nseuf/NixieTubeClock/README.md

# NixieTubeClock
NixieTubeClock is a GPS-based desk clock that is precise up to 10ms, and uses nixie tubes to display the time.
