nseuf/NixieTubeClock/electronics/USBC_passthrough/production/bom.csv

Designator | Footprint | Quantity | Value | LCSC Part #
J1 | TYPE-C-SMD_USB4120-03-C | 1 | USB_C_Receptacle_USB2.0_16P
J2 | USB-C-SMD_TYPEC-302-BRP16SC16 | 1 | USB_C_Receptacle_USB2.0_16P
R1, R2 | 0603 | 2 | 5k1
