nseuf/NixieTubeClock/cad/2025.06.11.Clock.PCB Holder Part2.STL

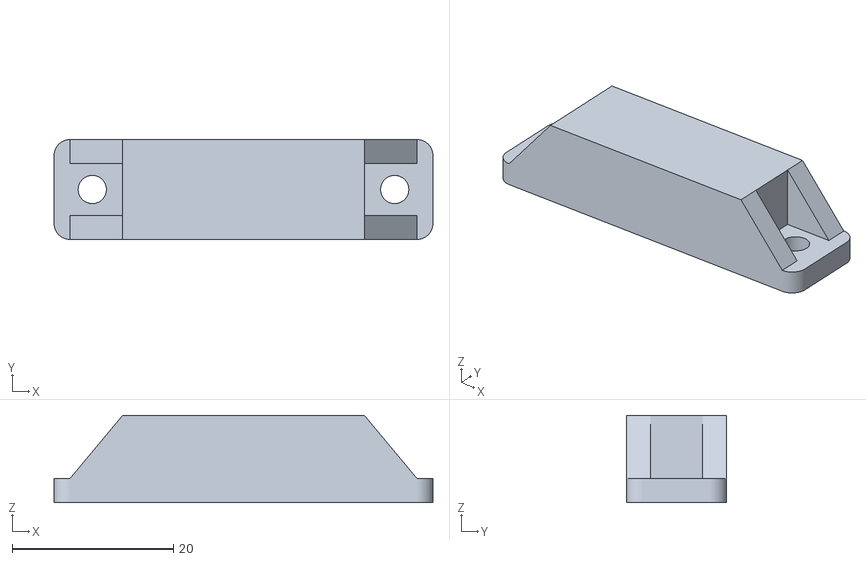
[picture p1: CAD file, 2025-11-16]
cad/2025.06.11.Clock.PCB Holder Part2.STL
47.0 x 12.4 x 10.8
