nseuf/NixieTubeClock/electronics/gps_clock/KiCADv6/KiCADv6/7447709330/WE-PD_1210.step

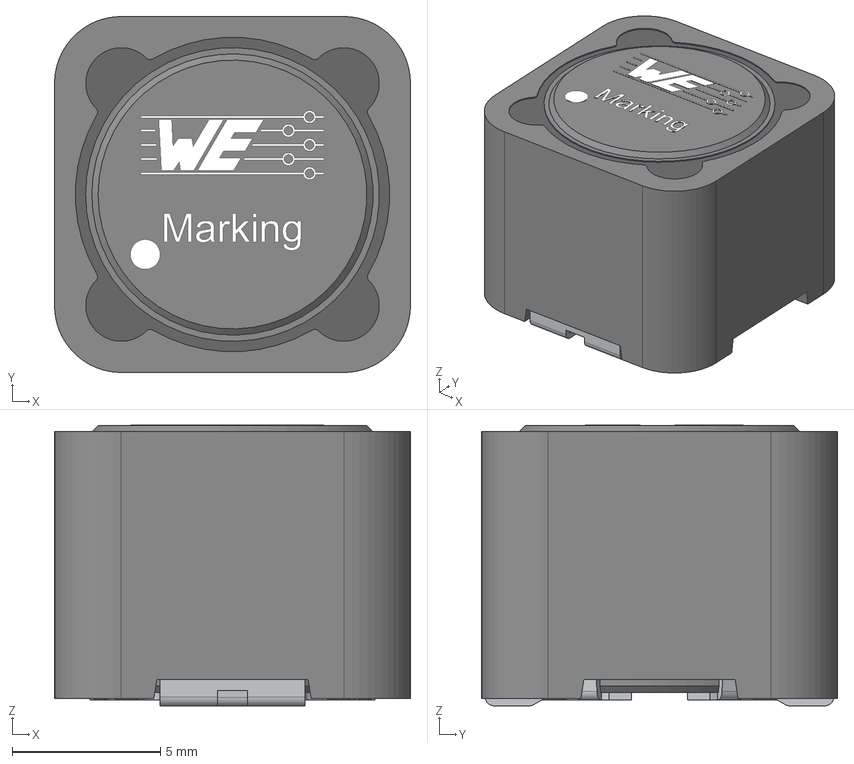
[picture p2: CAD file, 2025-08-10]
electronics/gps_clock/KiCADv6/KiCADv6/7447709330/WE-PD_1210.step
12.0 x 12.0 x 9.46 mm
Core
ShieldRing
Glue
Leadframe
