nseuf/NixieTubeClock/electronics/touch_sensor/TouchSensor.step

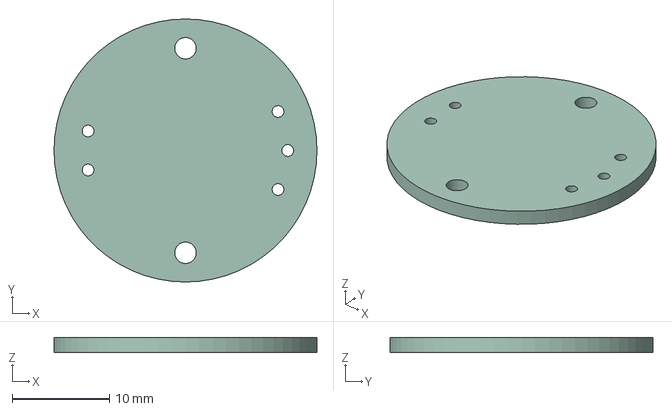
[picture p4: CAD file, 2025-08-10]
electronics/touch_sensor/TouchSensor.step
27.0 x 27.0 x 1.51 mm
