nseuf/NixieTubeClock/cad/2025.06.16.Clock.PCB Holder Part1.STL

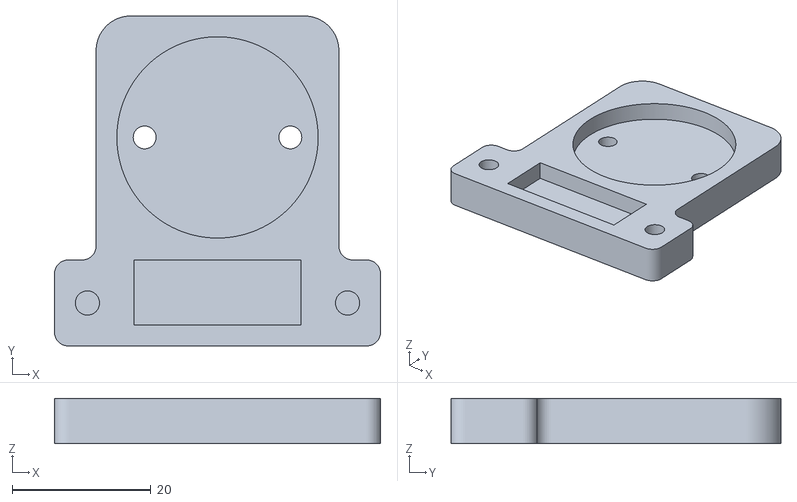
[picture p5: CAD file, 2025-11-16]
cad/2025.06.16.Clock.PCB Holder Part1.STL
47.0 x 47.6 x 6.50
