nseuf/NixieTubeClock/electronics/touch_sensor/Manufacturing/TouchSensor-B_Cu.dxf

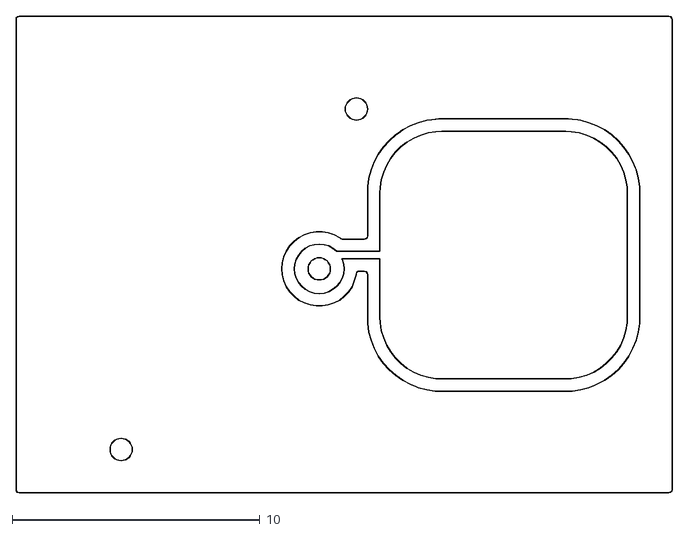
[picture p6: CAD file, 2025-08-10]
electronics/touch_sensor/Manufacturing/TouchSensor-B_Cu.dxf
26.5 x 19.2
