nseuf/NixieTubeClock/electronics/touch_sensor/Manufacturing/TouchSensor-User_Eco1.dxf

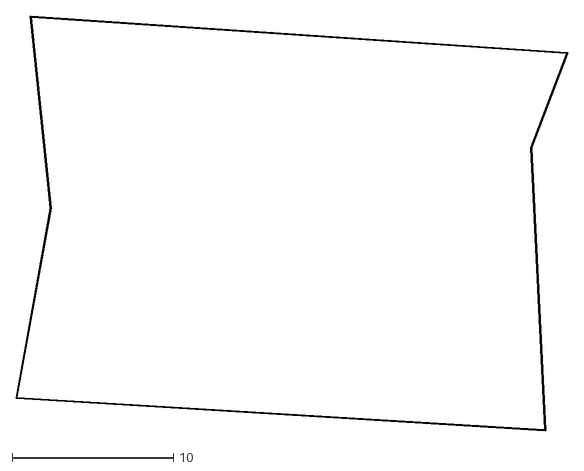
[picture p7: CAD file, 2025-08-10]
electronics/touch_sensor/Manufacturing/TouchSensor-User_Eco1.dxf
34.2 x 25.7
