nseuf/NixieTubeClock/electronics/touch_sensor/Manufacturing/TouchSensor-Edge_Cuts.dxf

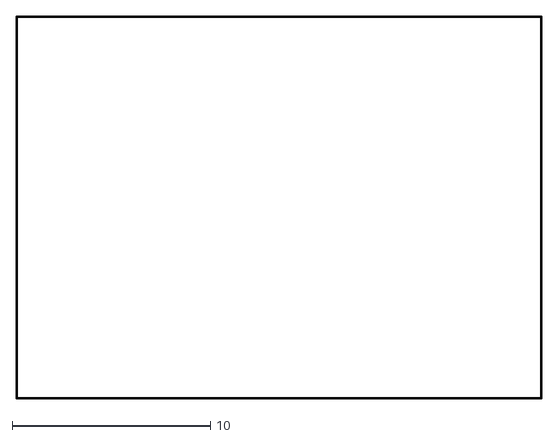
[picture p8: CAD file, 2025-08-10]
electronics/touch_sensor/Manufacturing/TouchSensor-Edge_Cuts.dxf
26.6 x 19.3
