nseuf/NixieTubeClock/(list of files, cad)

Other CAD files:
cad/BackFace.x_t
cad/Clock.Housing.x_t
cad/FrontFace.x_t
electronics/touch_sensor/Manufacturing/TouchSensor-B_Mask.dxf
electronics/touch_sensor/Manufacturing/TouchSensor-F_Mask.dxf
