nseuf/NixieTubeClock/cad/2025.08.11.Assem Clock.pdf

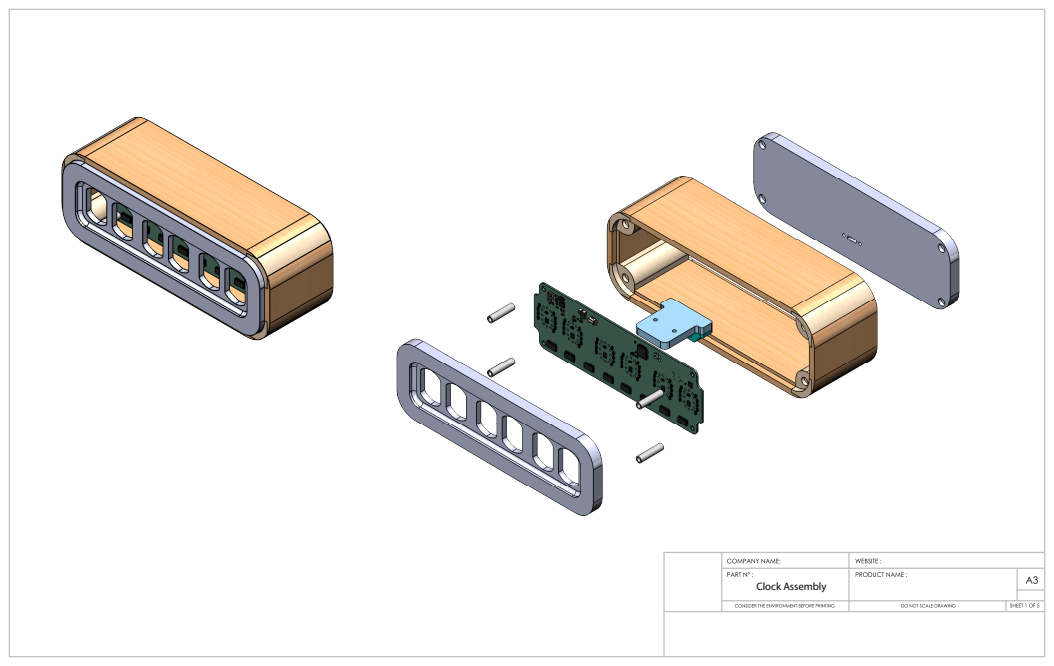
[picture p11: page 1]
Clock Assembly

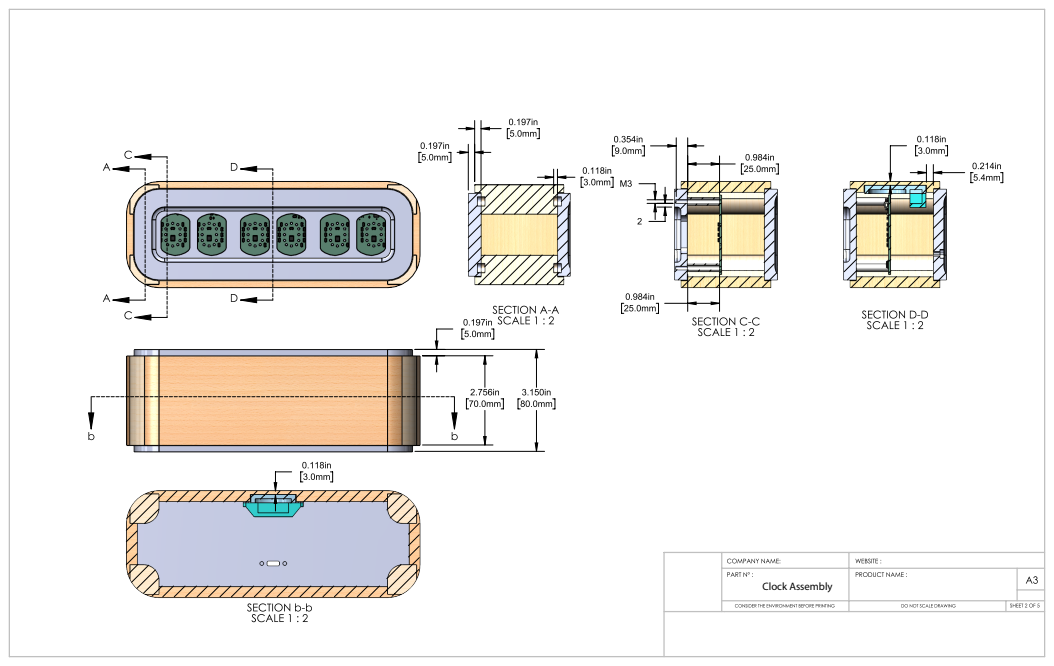
[picture p12: page 2]
Clock Assembly

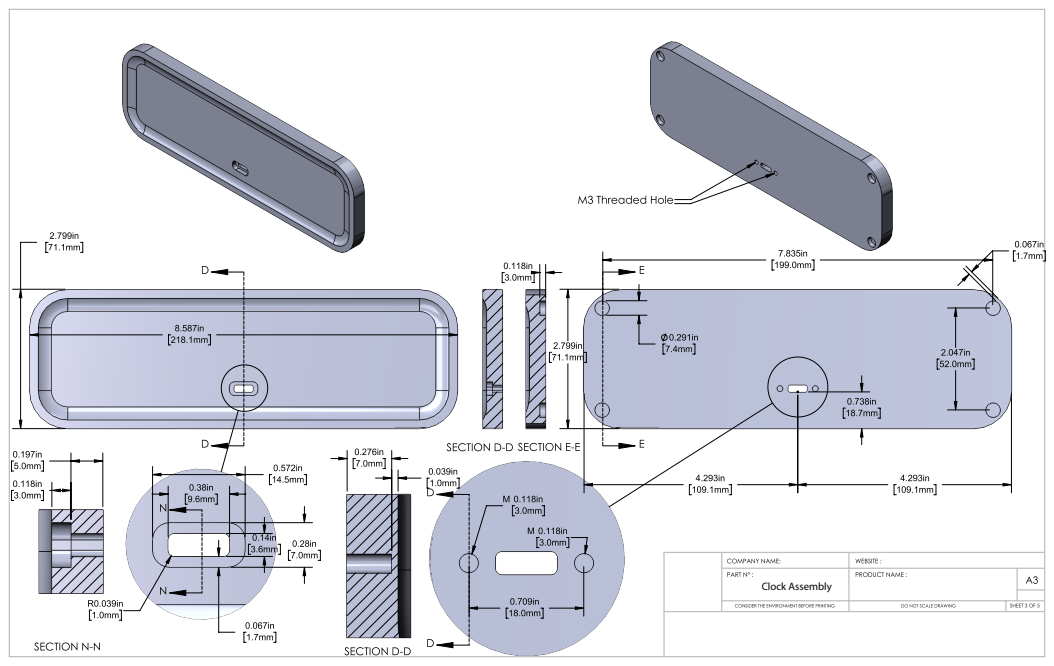
[picture p13: page 3]
Clock Assembly

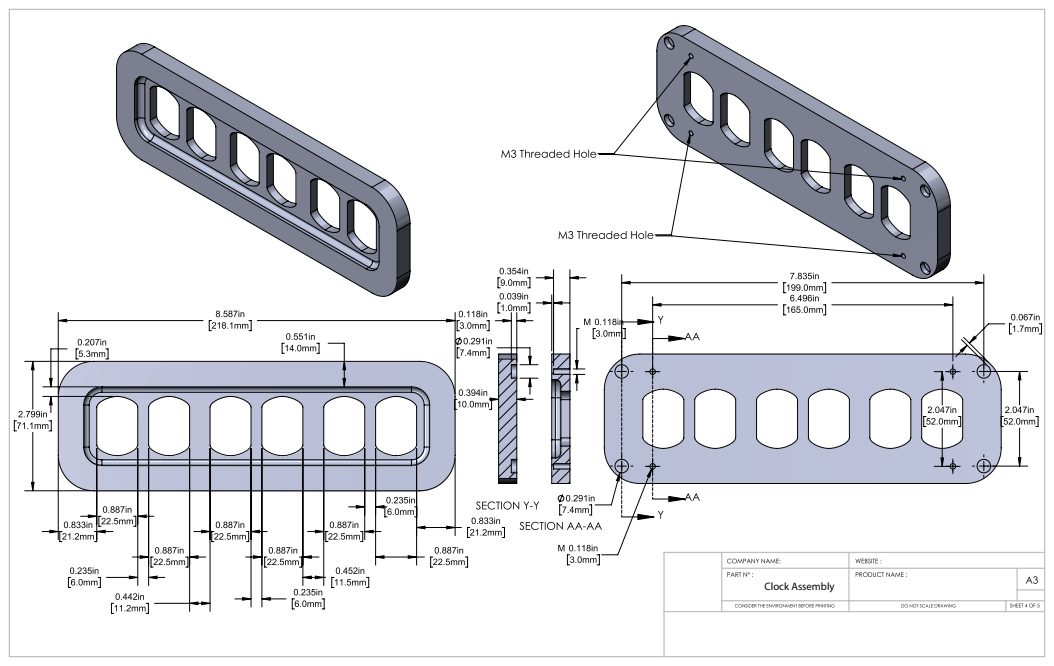
[picture p14: page 4]
Clock Assembly

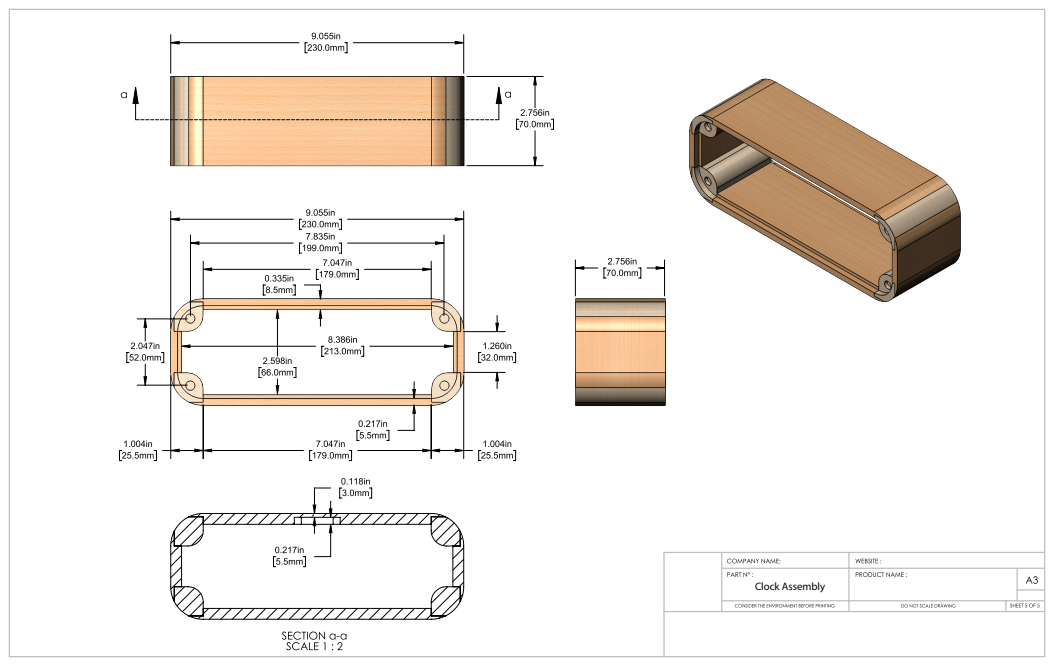
[picture p15: page 5]
Clock Assembly
