nseuf/NixieTubeClock/(list of files, drawings)

Other design files:
electronics/gps_clock/gps_clock.dsn
