nseuf/NixieTubeClock/electronics/USBC_passthrough/USBCPassthrough.kicad_pcb

## KiCad design electronics/USBC_passthrough/USBCPassthrough.kicad_pcb (2025-11-16)

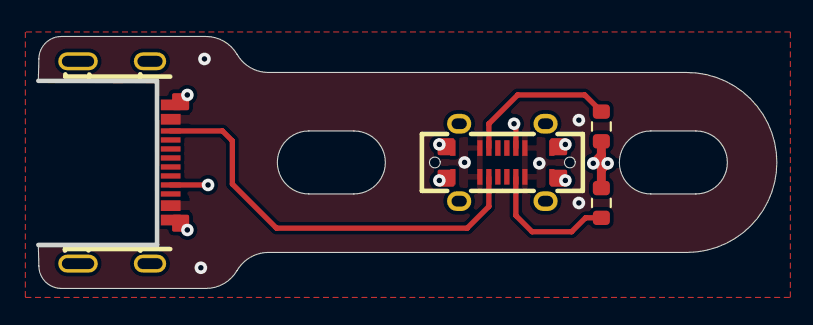
[picture p16: board USBCPassthrough.kicad_pcb from above]

Board: 4 copper layers, 41.0 x 14.0 mm, 4 parts (0 on the bottom side), 6 nets.

Parts:
J1: USB_C_Receptacle_USB2.0_16P; TYPE-C-SMD_USB4120-03-C
J2: USB_C_Receptacle_USB2.0_16P; USB-C-SMD_TYPEC-302-BRP16SC16
R1, R2: 5k1; R_0603_1608Metric

Connections:
+5V: J1.A4 (VBUS), J1.A9 (VBUS), J1.B4 (VBUS), J1.B9 (VBUS), J2.A4 (VBUS), J2.B4 (VBUS)
GND: J1.A1 (GND), J1.A12 (GND), J1.B1 (GND), J1.B12 (GND), J1.S1 (SHIELD), J2.A1 (GND), J2.B1 (GND), J2.S1 (SHIELD), R1.2, R2.2
unnamed: J1.A5 (CC1), R2.1
unnamed: J1.B5 (CC2), R1.1
unnamed: J1.A8 (SBU1), J2.A8 (SBU1)
unnamed: J1.B8 (SBU2), J2.B8 (SBU2)
