nseuf/NixieTubeClock/electronics/touch_sensor/TouchSensor.kicad_pcb

## KiCad design electronics/touch_sensor/TouchSensor.kicad_pcb (2025-08-10)

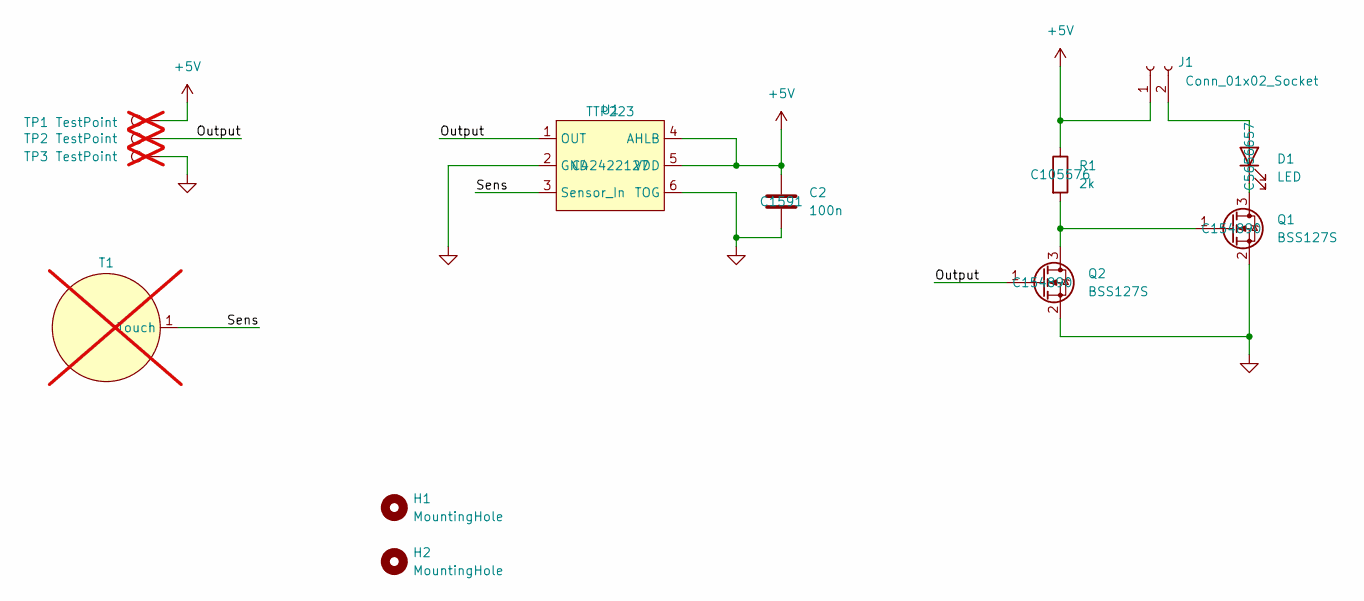
[picture p17: schematic TouchSensor.kicad_sch]

Parts:
C2: 100n; C_0603_1608Metric; LCSC_Part# C1591
D1: LED; D_0603_1608Metric; LCSC_Part# C5656657
H1, H2: MountingHole; MountingHole_2.2mm_M2_ISO7380
J1: Conn_01x02_Socket; JST_SUR_BM02B-SURS-TF_1x02-1MP_P0.80mm_Vertical
Q1, Q2: BSS127S; SOT-23; LCSC_Part# C154890
R1: 2k; R_0603_1608Metric; LCSC_Part# C105576
T1: TouchPad; not fitted
TP1, TP2, TP3: TestPoint; TestPoint_THTPad_D2.5mm_Drill1.2mm; not fitted
U1: TTP223; SOT-23-6; LCSC_Part# C42422127

Connections:
+5V: C2.1, J1.1, R1.1, TP1.1, U1.4 (AHLB), U1.5 (VDD)
/Output: Q2.1 (G), TP2.1, U1.1 (OUT)
/Sens: T1.1 (Touch), U1.3 (Sensor_In)
GND: C2.2, Q1.2 (S), Q2.2 (S), TP3.1, U1.2 (GND), U1.6 (TOG)
unnamed: D1.2 (A), J1.2
unnamed: D1.1 (K), Q1.3 (D)
unnamed: Q1.1 (G), Q2.3 (D), R1.2

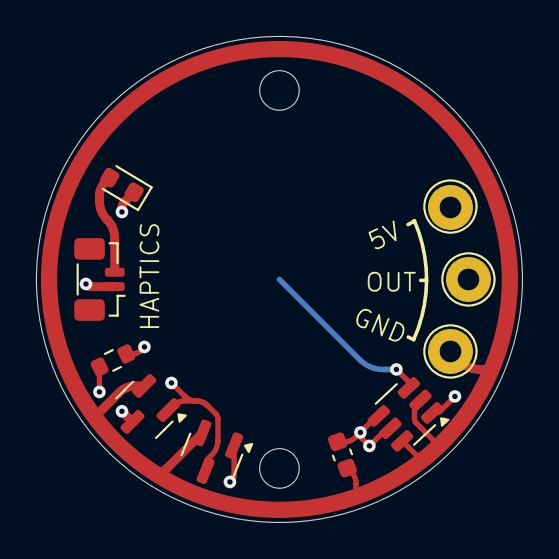
[picture p18: board TouchSensor.kicad_pcb from above]

Board: 4 copper layers, 27.0 x 27.0 mm, 13 parts (1 on the bottom side), 7 nets.
