nseuf/NixieTubeClock/electronics/gps_clock/gps_clock.kicad_pcb

## KiCad design electronics/gps_clock/gps_clock.kicad_pcb (2025-08-10)

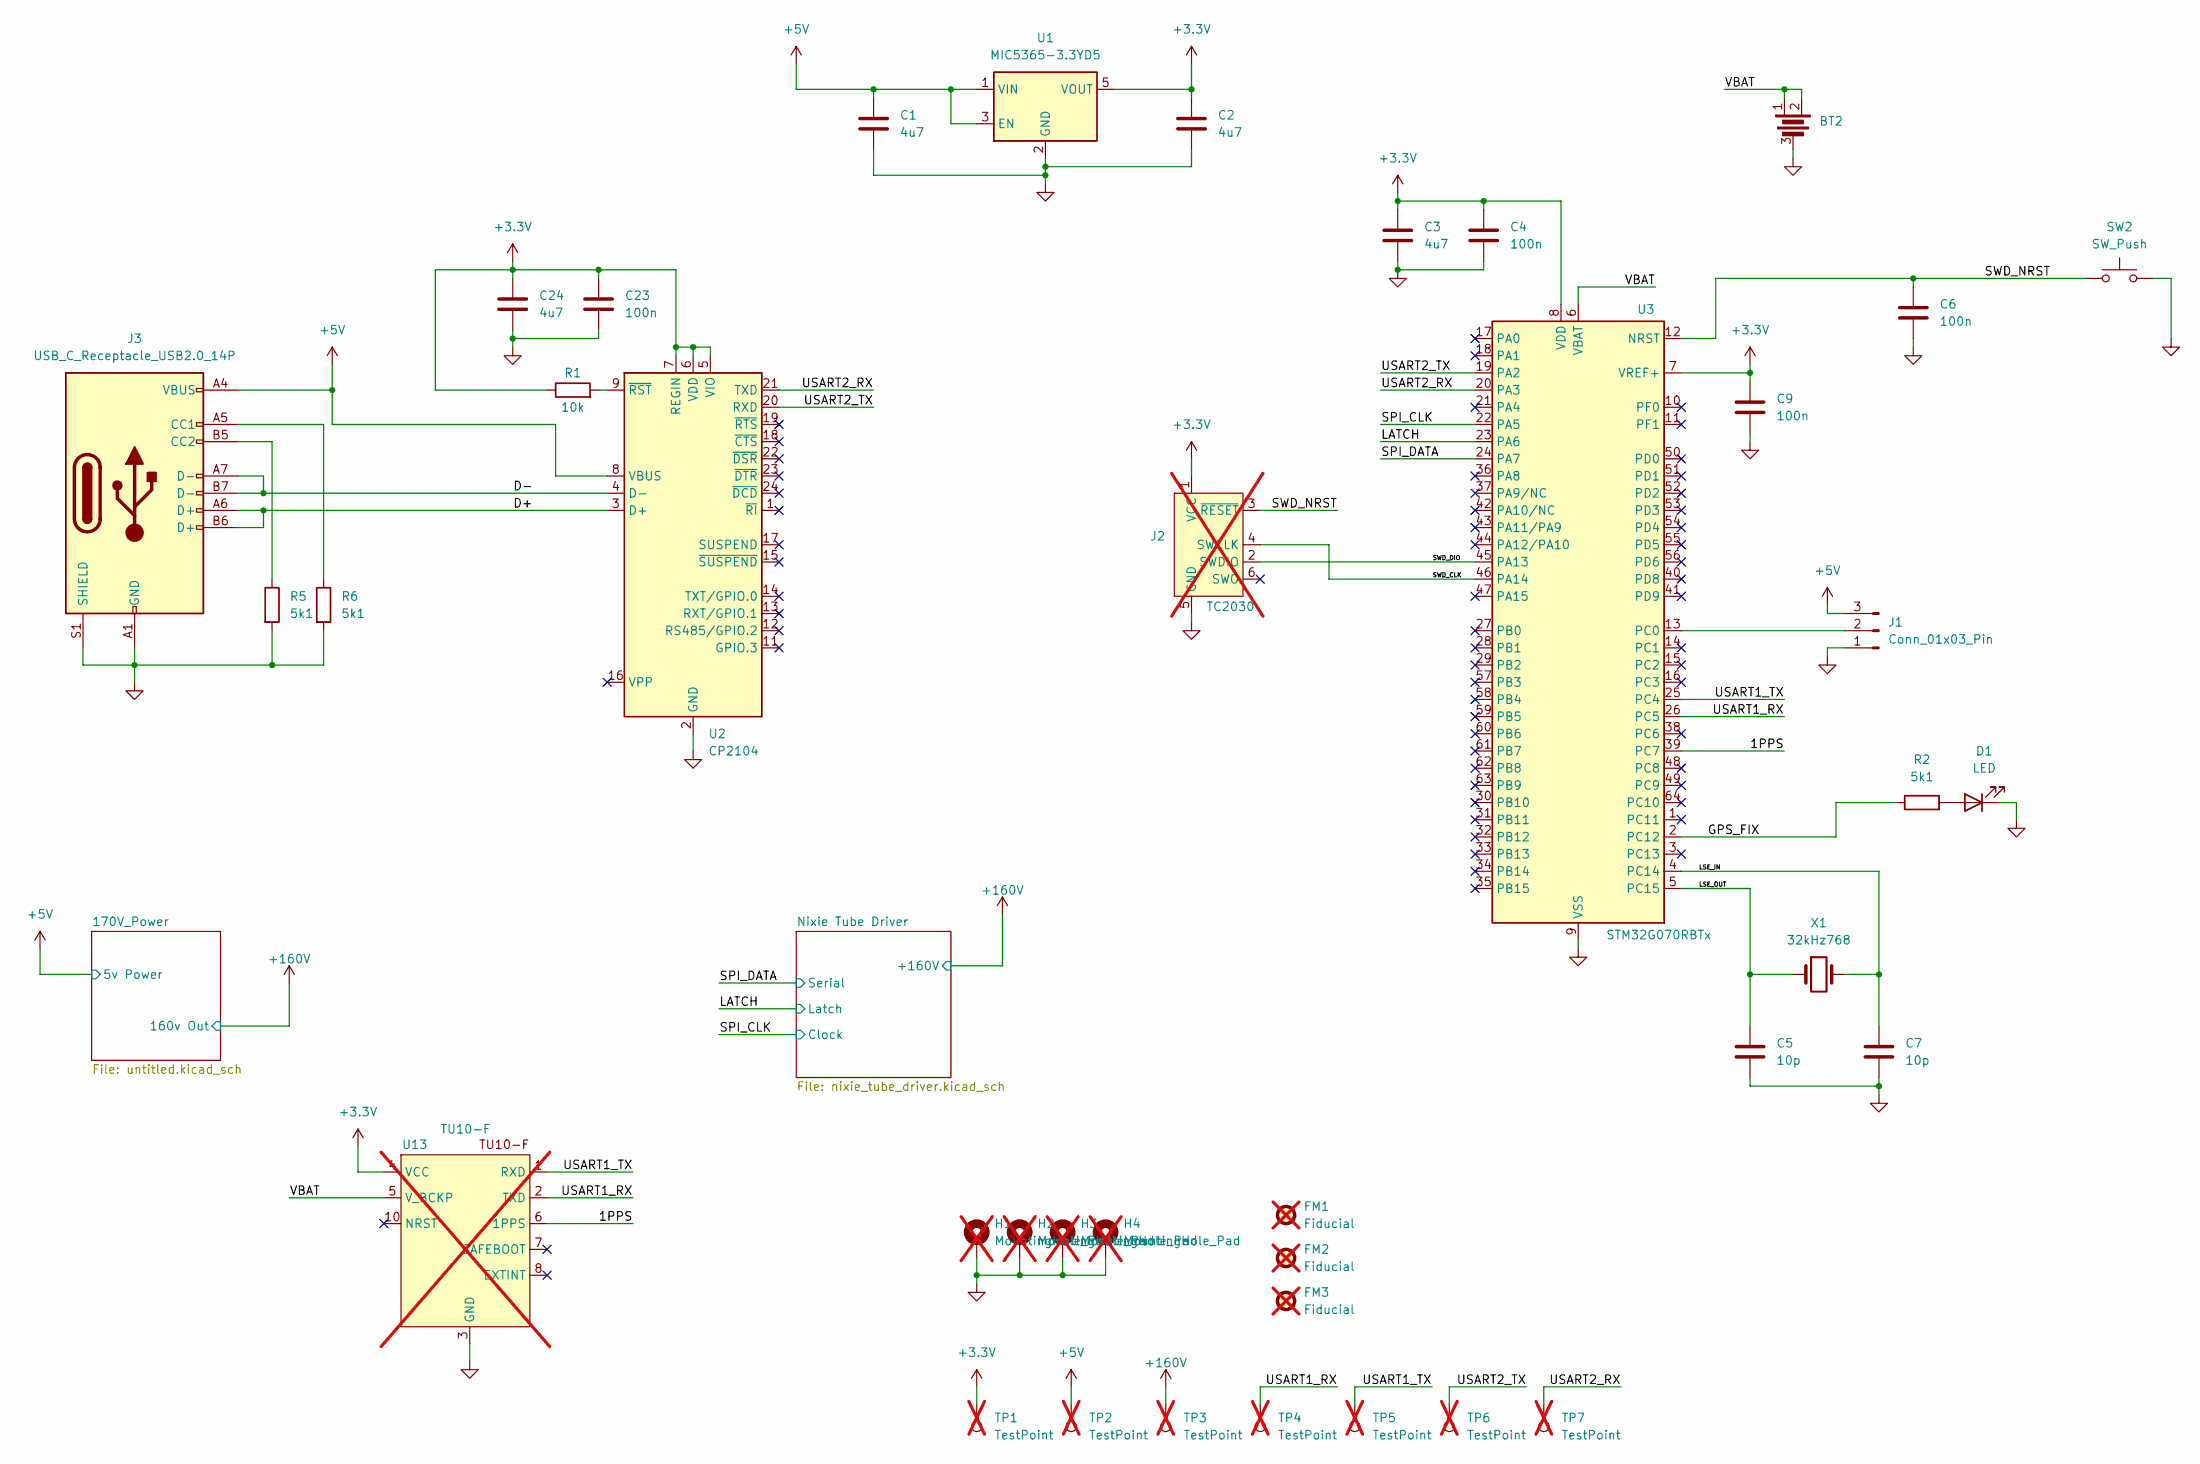
[picture p19: schematic gps_clock.kicad_sch, GPS Clock]

Parts:
BT2: BAT-SMD_MY-1220-03; LCSC_Part# C20606802
C1, C2, C3, C24: 4u7; C_0603_1608Metric; MFR_Part# CL10A475KP8NNNC; LCSC_Part# C1705
C4, C6, C9, C23: 100n; C_0402_1005Metric; MFR_Part# CL05B104KO5NNNC; LCSC_Part# C1525
C5, C7: 10p; C_0402_1005Metric; MFR_Part# 0402CG100J500NT; LCSC_Part# C1545
D1: LED; D_0603_1608Metric; LCSC_Part# C5656657
FM1, FM2, FM3: Fiducial; Fiducial_1mm_Mask2mm; not fitted
H1, H2, H3, H4: MountingHole_Pad; MountingHole_3mm_Pad_Via; not fitted
J1: Conn_01x03_Pin; Molex_PicoBlade_53261-0371_1x03-1MP_P1.25mm_Horizontal; LCSC_Part# C293630
J2: TC2030; Tag-Connect_TC2030-IDC-FP_2x03_P1.27mm_Vertical; MFR_Part# N/A; LCSC_Part# N/A; not fitted
J3: USB_C_Receptacle_USB2.0_14P; USB-C-SMD_U263-241N-4BQC02; LCSC_Part# C2689742
R1: 10k; R_0603_1608Metric; MFR_Part# 0402WGF5101TCE; LCSC_Part# C15401
R2, R5, R6: 5k1; R_0402_1005Metric; MFR_Part# 0402WGF5101TCE; LCSC_Part# C25905
SW2: SW_Push; SW_Push_1P1T_XKB_TS-1187A; MFR_Part# TS-1187A-B-A-B; LCSC_Part# C318884
TP1, TP2, TP3, TP4, TP5, TP6, TP7: TestPoint; TestPoint_Pad_D2.5mm; LCSC_Part# N/A; not fitted
U1: MIC5365-3.3YD5; SOT-23-5; MFR_Part# MIC5365-3.3YD5-TR; LCSC_Part# C626098
U2: CP2104; QFN-24-1EP_4x4mm_P0.5mm_EP2.7x2.7mm; LCSC_Part# C47742
U3: STM32G070RBTx; LQFP-64_10x10mm_P0.5mm; MFR_Part# STM32G070RBT6; LCSC_Part# C529340
U13: TU10-F; LCSC_Part# N/A; not fitted
X1: 32kHz768; Crystal_SMD_2012-2Pin_2.0x1.2mm; MFR_Part# NX2012SA-32.768KHZ-EXS00A-MU00644; LCSC_Part# C2828558

Connections:
+3.3V: C2.1, C3.1, C4.1, C9.1, C23.1, C24.1, J2.1 (VCC), R1.1, TP1.1, U1.5 (VOUT), U2.5 (VIO), U2.6 (VDD), U2.7 (REGIN), U3.7 (VREF+), U3.8 (VDD), U13.4 (VCC)
+5V: C1.1, J1.3, J3.A4 (VBUS), J3.A9 (VBUS), J3.B4 (VBUS), J3.B9 (VBUS), TP2.1, U1.1 (VIN), U1.3 (EN), U2.8 (VBUS); also elsewhere on the board
+160V: TP3.1; also elsewhere on the board
/1PPS: U3.39 (PC7), U13.6 (1PPS)
/D+: J3.A6 (D+), J3.B6 (D+), U2.3 (D+)
/D-: J3.A7 (D-), J3.B7 (D-), U2.4 (D-)
/GPS_FIX: R2.1, U3.2 (PC12)
/LATCH: U3.23 (PA6); also elsewhere on the board
/LSE_IN: C7.1, U3.4 (PC14), X1.2
/LSE_OUT: C5.1, U3.5 (PC15), X1.1
/SPI_CLK: U3.22 (PA5); also elsewhere on the board
/SPI_DATA: U3.24 (PA7); also elsewhere on the board
/SWD_CLK: J2.4 (SWCLK), U3.46 (PA14)
/SWD_DIO: J2.2 (SWDIO), U3.45 (PA13)
/SWD_NRST: C6.1, J2.3 (~RESET), SW2.1, U3.12 (NRST)
/USART1_RX: TP4.1, U3.26 (PC5), U13.2 (TXD)
/USART1_TX: TP5.1, U3.25 (PC4), U13.1 (RXD)
/USART2_RX: TP7.1, U2.21 (TXD), U3.20 (PA3)
/USART2_TX: TP6.1, U2.20 (RXD), U3.19 (PA2)
/VBAT: BT2.1, BT2.2, U3.6 (VBAT), U13.5 (V_BCKP)
GND: BT2.3, C1.2, C2.2, C3.2, C4.2, C5.2, C6.2, C7.2, C9.2, C23.2, C24.2, D1.1 (K), H1.1, H2.1, H3.1, H4.1, J1.1, J2.5 (GND), J3.A1 (GND), J3.A12 (GND), J3.B1 (GND), J3.B12 (GND), J3.S1 (SHIELD), R5.2, R6.2, SW2.2, U1.2 (GND), U2.2 (GND), U2.25 (GND), U3.9 (VSS), U13.3 (GND), U13.12 (GND); also elsewhere on the board
unnamed: D1.2 (A), R2.2
unnamed: J1.2, U3.13 (PC0)
unnamed: J3.A5 (CC1), R6.1
unnamed: J3.B5 (CC2), R5.1
unnamed: R1.2, U2.9 (~RST)

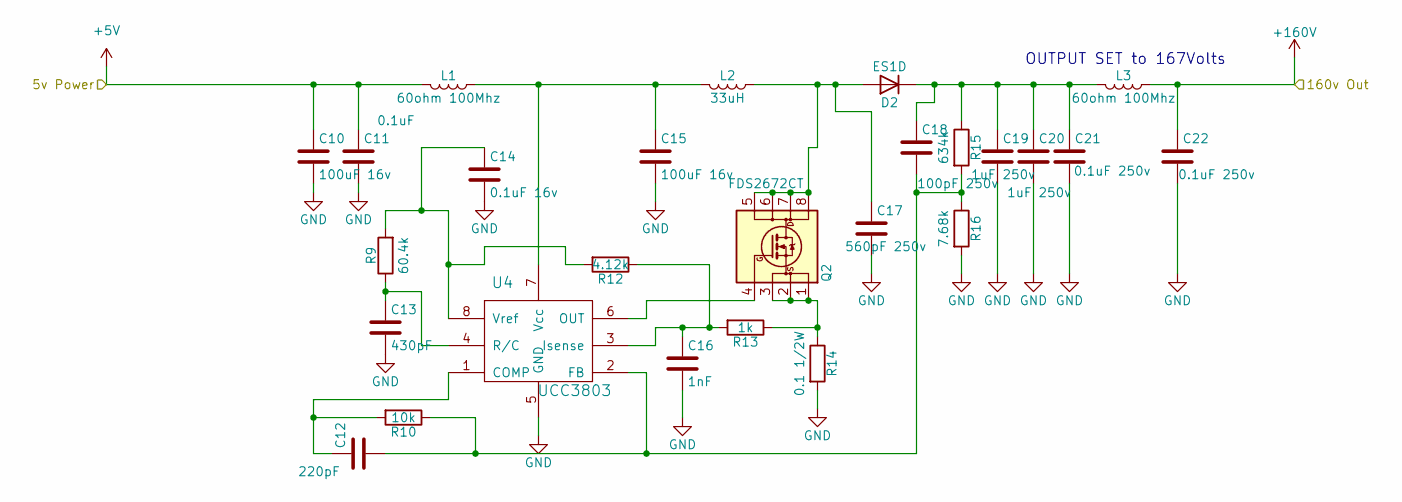
[picture p20: schematic untitled.kicad_sch, 170V Power Supply]

Parts:
C10, C15: 100uF 16v; C_1210_3225Metric; MPN EMK325ABJ107MM-P; LCSC_Part# C90143
C11: 0.1uF; C_0805_2012Metric; MPN C0805C104K3RACTU; LCSC_Part# C1852967
C12: 220pF; C_0805_2012Metric; MPN C0805C221M5RACTU; LCSC_Part# C1727
C13: 430pF; C_0805_2012Metric; MPN CL21C431JBANNNC; LCSC_Part# C67898
C14: 0.1uF 16v; C_0805_2012Metric; MPN C0805C104K3RACTU; LCSC_Part# C519980
C16: 1nF; C_0805_2012Metric; MPN C0805C102M5RACTU; LCSC_Part# C46553
C17: 560pF 250v; C_0805_2012Metric; MPN C0603C561JAGAC7867; LCSC_Part# C113870
C18: 100pF 250v; C_0805_2012Metric; MPN C0805C101JAGAC7800; LCSC_Part# C2929108
C19, C20: 1uF 250v; C_1812_4532Metric; MPN C4532X7T2E105M250KE; LCSC_Part# C106152
C21, C22: 0.1uF 250v; C_0805_2012Metric; MPN CGA4J3X7T2E104M125AE; LCSC_Part# C5451689
D2: ES1D; D_SMA; MPN ES1D; LCSC_Part# C84602
L1, L3: 60ohm 100Mhz; R_0805_2012Metric; MPN BKP2125HS600-T; LCSC_Part# C44362
L2: 33uH; WE-PD_1210; MPN 7447709330; LCSC_Part# C2651182
Q2: FDS2672CT; SOIC-8_3.9x4.9mm_P1.27mm; MPN FDS2672CT-ND; LCSC_Part# C463724
R9: 60.4k; R_0805_2012Metric; MPN RC0805FR-0760K4L; LCSC_Part# C218645
R10: 10k; R_0603_1608Metric; MFR_Part# 0603WAJ0103T5E; LCSC_Part# C15401
R12: 4.12k; R_0805_2012Metric; MPN RC0805FR-074K12L; LCSC_Part# C218607
R13: 1k; R_0805_2012Metric; MPN RC0805FR-071KL; LCSC_Part# C17513
R14: 0.1 1/2W; R_0805_2012Metric; MPN ERJ-6DSFR10V; LCSC_Part# C2935234
R15: 634k; R_0805_2012Metric; MPN RC0805FR-07634KL; LCSC_Part# C237126
R16: 7.68k; R_0805_2012Metric; MPN RC0805FR-077K68L; LCSC_Part# C30041
U4: UCC3803; D0008A_L; MPN UCC3803DTR; LCSC_Part# C2657971

Connections:
+5V: C10.1, C11.1, L1.2; also elsewhere on the board
+160V: C22.1, L3.1; also elsewhere on the board
GND: C10.2, C11.2, C13.2, C14.2, C15.2, C16.2, C17.2, C19.2, C20.2, C21.2, C22.2, R14.2, R16.2, U4.5 (GND); also elsewhere on the board
unnamed: C17.1, D2.2 (A), L2.1, Q2.5 (D), Q2.6 (D), Q2.7 (D), Q2.8 (D)
unnamed: C18.1, C19.1, C20.1, C21.1, D2.1 (K), L3.2, R15.1
unnamed: Q2.4 (G), U4.6 (OUT)
unnamed: Q2.1 (S), Q2.2 (S), Q2.3 (S), R13.1, R14.1
unnamed: C12.1, R10.2, U4.1 (COMP)
unnamed: C12.2, C18.2, R10.1, R15.2, R16.1, U4.2 (FB)
unnamed: C16.1, R12.1, R13.2, U4.3 (Isense)
unnamed: C13.1, R9.1, U4.4 (R/C)
unnamed: C15.1, L1.1, L2.2, U4.7 (Vcc)
unnamed: C14.1, R9.2, R12.2, U4.8 (Vref)

Notes on the sheet:
OUTPUT SET to 167Volts

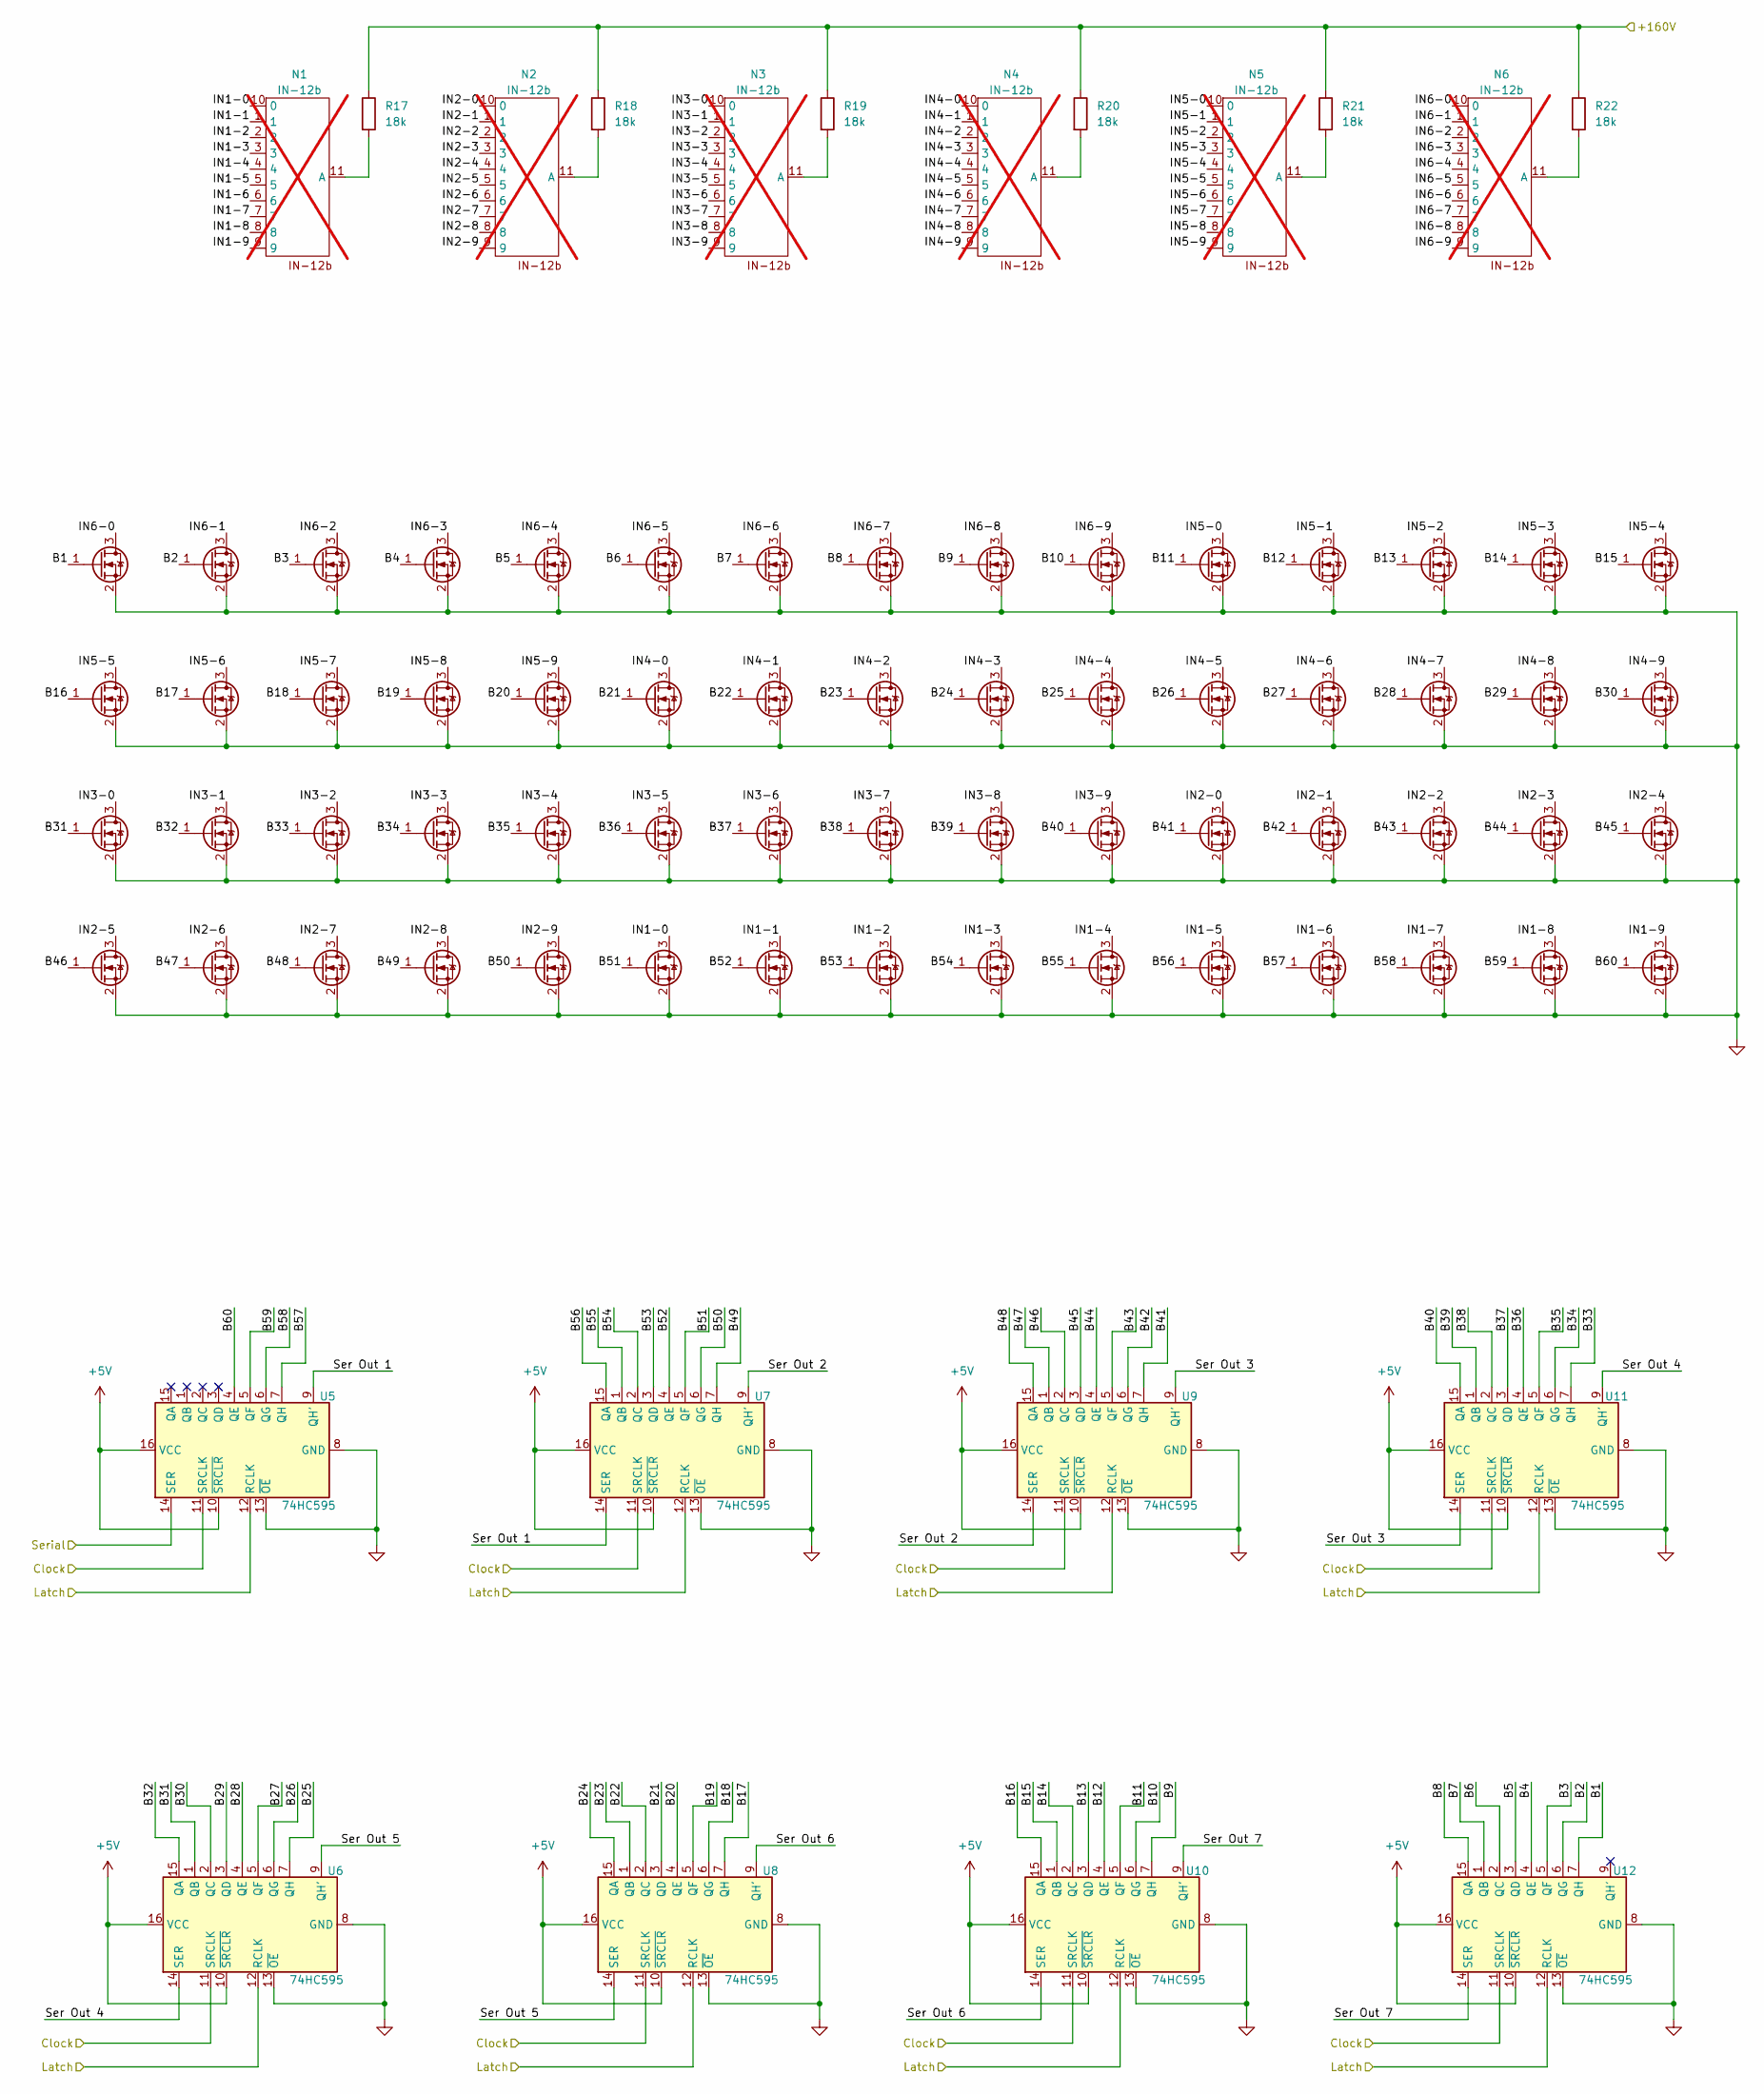
[picture p21: schematic nixie_tube_driver.kicad_sch, Nixie Tube Driver]

Parts:
N1, N2, N3, N4, N5, N6: IN-12b; MFR_Part# IN-12b; LCSC_Part# N/A; not fitted
Q3, Q4, Q5, Q6, Q7, Q8, Q9, Q10, Q11, Q12, Q13, Q14, Q15, Q16, Q17, Q18, Q19, Q20, Q21, Q22, Q23, Q24, Q25, Q26, Q27, Q28, Q29, Q30, Q31, Q32, Q33, Q34, Q35, Q36, Q37, Q38, Q39, Q40, Q41, Q42, Q43, Q44, Q45, Q46, Q47, Q48, Q49, Q50, Q51, Q52, Q53, Q54, Q55, Q56, Q57, Q58, Q59, Q60, Q61, Q62: BSS127S; SOT-23; MFR_Part# BSS127S-7; LCSC_Part# C154890
R17, R18, R19, R20, R21, R22: 18k; R_1812_4532Metric; MFR_Part# 181207F1802T4E; LCSC_Part# C422140
U5, U6, U7, U8, U9, U10, U11, U12: 74HC595; SOIC-16W_5.3x10.2mm_P1.27mm; MFR_Part# 74HC595; LCSC_Part# C18164493

Connections:
+5V: U5.10 (~SRCLR), U5.16 (VCC), U6.10 (~SRCLR), U6.16 (VCC), U7.10 (~SRCLR), U7.16 (VCC), U8.10 (~SRCLR), U8.16 (VCC), U9.10 (~SRCLR), U9.16 (VCC), U10.10 (~SRCLR), U10.16 (VCC), U11.10 (~SRCLR), U11.16 (VCC), U12.10 (~SRCLR), U12.16 (VCC); also elsewhere on the board
+160V: R17.1, R18.1, R19.1, R20.1, R21.1, R22.1; also elsewhere on the board
/LATCH: U5.12 (RCLK), U6.12 (RCLK), U7.12 (RCLK), U8.12 (RCLK), U9.12 (RCLK), U10.12 (RCLK), U11.12 (RCLK), U12.12 (RCLK); also elsewhere on the board
/Nixie Tube Driver/B1: Q3.1 (G), U12.7 (QH)
/Nixie Tube Driver/B2: Q7.1 (G), U12.6 (QG)
/Nixie Tube Driver/B3: Q11.1 (G), U12.5 (QF)
/Nixie Tube Driver/B4: Q15.1 (G), U12.4 (QE)
/Nixie Tube Driver/B5: Q19.1 (G), U12.3 (QD)
/Nixie Tube Driver/B6: Q23.1 (G), U12.2 (QC)
/Nixie Tube Driver/B7: Q27.1 (G), U12.1 (QB)
/Nixie Tube Driver/B8: Q31.1 (G), U12.15 (QA)
/Nixie Tube Driver/B9: Q35.1 (G), U10.7 (QH)
/Nixie Tube Driver/B10: Q39.1 (G), U10.6 (QG)
/Nixie Tube Driver/B11: Q43.1 (G), U10.5 (QF)
/Nixie Tube Driver/B12: Q47.1 (G), U10.4 (QE)
/Nixie Tube Driver/B13: Q51.1 (G), U10.3 (QD)
/Nixie Tube Driver/B14: Q55.1 (G), U10.2 (QC)
/Nixie Tube Driver/B15: Q59.1 (G), U10.1 (QB)
/Nixie Tube Driver/B16: Q4.1 (G), U10.15 (QA)
/Nixie Tube Driver/B17: Q8.1 (G), U8.7 (QH)
/Nixie Tube Driver/B18: Q12.1 (G), U8.6 (QG)
/Nixie Tube Driver/B19: Q16.1 (G), U8.5 (QF)
/Nixie Tube Driver/B20: Q20.1 (G), U8.4 (QE)
/Nixie Tube Driver/B21: Q24.1 (G), U8.3 (QD)
/Nixie Tube Driver/B22: Q28.1 (G), U8.2 (QC)
/Nixie Tube Driver/B23: Q32.1 (G), U8.1 (QB)
/Nixie Tube Driver/B24: Q36.1 (G), U8.15 (QA)
/Nixie Tube Driver/B25: Q40.1 (G), U6.7 (QH)
/Nixie Tube Driver/B26: Q44.1 (G), U6.6 (QG)
/Nixie Tube Driver/B27: Q48.1 (G), U6.5 (QF)
/Nixie Tube Driver/B28: Q52.1 (G), U6.4 (QE)
/Nixie Tube Driver/B29: Q56.1 (G), U6.3 (QD)
/Nixie Tube Driver/B30: Q60.1 (G), U6.2 (QC)
/Nixie Tube Driver/B31: Q5.1 (G), U6.1 (QB)
/Nixie Tube Driver/B32: Q9.1 (G), U6.15 (QA)
/Nixie Tube Driver/B33: Q13.1 (G), U11.7 (QH)
/Nixie Tube Driver/B34: Q17.1 (G), U11.6 (QG)
/Nixie Tube Driver/B35: Q21.1 (G), U11.5 (QF)
/Nixie Tube Driver/B36: Q25.1 (G), U11.4 (QE)
/Nixie Tube Driver/B37: Q29.1 (G), U11.3 (QD)
/Nixie Tube Driver/B38: Q33.1 (G), U11.2 (QC)
/Nixie Tube Driver/B39: Q37.1 (G), U11.1 (QB)
/Nixie Tube Driver/B40: Q41.1 (G), U11.15 (QA)
/Nixie Tube Driver/B41: Q45.1 (G), U9.7 (QH)
/Nixie Tube Driver/B42: Q49.1 (G), U9.6 (QG)
/Nixie Tube Driver/B43: Q53.1 (G), U9.5 (QF)
/Nixie Tube Driver/B44: Q57.1 (G), U9.4 (QE)
/Nixie Tube Driver/B45: Q61.1 (G), U9.3 (QD)
/Nixie Tube Driver/B46: Q6.1 (G), U9.2 (QC)
/Nixie Tube Driver/B47: Q10.1 (G), U9.1 (QB)
/Nixie Tube Driver/B48: Q14.1 (G), U9.15 (QA)
/Nixie Tube Driver/B49: Q18.1 (G), U7.7 (QH)
/Nixie Tube Driver/B50: Q22.1 (G), U7.6 (QG)
/Nixie Tube Driver/B51: Q26.1 (G), U7.5 (QF)
/Nixie Tube Driver/B52: Q30.1 (G), U7.4 (QE)
/Nixie Tube Driver/B53: Q34.1 (G), U7.3 (QD)
/Nixie Tube Driver/B54: Q38.1 (G), U7.2 (QC)
/Nixie Tube Driver/B55: Q42.1 (G), U7.1 (QB)
/Nixie Tube Driver/B56: Q46.1 (G), U7.15 (QA)
/Nixie Tube Driver/B57: Q50.1 (G), U5.7 (QH)
/Nixie Tube Driver/B58: Q54.1 (G), U5.6 (QG)
/Nixie Tube Driver/B59: Q58.1 (G), U5.5 (QF)
/Nixie Tube Driver/B60: Q62.1 (G), U5.4 (QE)
/Nixie Tube Driver/IN1-0: N1.10 (0), Q26.3 (D)
/Nixie Tube Driver/IN1-1: N1.1, Q30.3 (D)
/Nixie Tube Driver/IN1-2: N1.2, Q34.3 (D)
/Nixie Tube Driver/IN1-3: N1.3, Q38.3 (D)
/Nixie Tube Driver/IN1-4: N1.4, Q42.3 (D)
/Nixie Tube Driver/IN1-5: N1.5, Q46.3 (D)
/Nixie Tube Driver/IN1-6: N1.6, Q50.3 (D)
/Nixie Tube Driver/IN1-7: N1.7, Q54.3 (D)
/Nixie Tube Driver/IN1-8: N1.8, Q58.3 (D)
/Nixie Tube Driver/IN1-9: N1.9, Q62.3 (D)
/Nixie Tube Driver/IN2-0: N2.10 (0), Q45.3 (D)
/Nixie Tube Driver/IN2-1: N2.1, Q49.3 (D)
/Nixie Tube Driver/IN2-2: N2.2, Q53.3 (D)
/Nixie Tube Driver/IN2-3: N2.3, Q57.3 (D)
/Nixie Tube Driver/IN2-4: N2.4, Q61.3 (D)
/Nixie Tube Driver/IN2-5: N2.5, Q6.3 (D)
/Nixie Tube Driver/IN2-6: N2.6, Q10.3 (D)
/Nixie Tube Driver/IN2-7: N2.7, Q14.3 (D)
/Nixie Tube Driver/IN2-8: N2.8, Q18.3 (D)
/Nixie Tube Driver/IN2-9: N2.9, Q22.3 (D)
/Nixie Tube Driver/IN3-0: N3.10 (0), Q5.3 (D)
/Nixie Tube Driver/IN3-1: N3.1, Q9.3 (D)
/Nixie Tube Driver/IN3-2: N3.2, Q13.3 (D)
/Nixie Tube Driver/IN3-3: N3.3, Q17.3 (D)
/Nixie Tube Driver/IN3-4: N3.4, Q21.3 (D)
/Nixie Tube Driver/IN3-5: N3.5, Q25.3 (D)
/Nixie Tube Driver/IN3-6: N3.6, Q29.3 (D)
/Nixie Tube Driver/IN3-7: N3.7, Q33.3 (D)
/Nixie Tube Driver/IN3-8: N3.8, Q37.3 (D)
/Nixie Tube Driver/IN3-9: N3.9, Q41.3 (D)
/Nixie Tube Driver/IN4-0: N4.10 (0), Q24.3 (D)
/Nixie Tube Driver/IN4-1: N4.1, Q28.3 (D)
/Nixie Tube Driver/IN4-2: N4.2, Q32.3 (D)
/Nixie Tube Driver/IN4-3: N4.3, Q36.3 (D)
/Nixie Tube Driver/IN4-4: N4.4, Q40.3 (D)
/Nixie Tube Driver/IN4-5: N4.5, Q44.3 (D)
/Nixie Tube Driver/IN4-6: N4.6, Q48.3 (D)
/Nixie Tube Driver/IN4-7: N4.7, Q52.3 (D)
/Nixie Tube Driver/IN4-8: N4.8, Q56.3 (D)
/Nixie Tube Driver/IN4-9: N4.9, Q60.3 (D)
/Nixie Tube Driver/IN5-0: N5.10 (0), Q43.3 (D)
/Nixie Tube Driver/IN5-1: N5.1, Q47.3 (D)
/Nixie Tube Driver/IN5-2: N5.2, Q51.3 (D)
/Nixie Tube Driver/IN5-3: N5.3, Q55.3 (D)
/Nixie Tube Driver/IN5-4: N5.4, Q59.3 (D)
/Nixie Tube Driver/IN5-5: N5.5, Q4.3 (D)
/Nixie Tube Driver/IN5-6: N5.6, Q8.3 (D)
/Nixie Tube Driver/IN5-7: N5.7, Q12.3 (D)
/Nixie Tube Driver/IN5-8: N5.8, Q16.3 (D)
/Nixie Tube Driver/IN5-9: N5.9, Q20.3 (D)
/Nixie Tube Driver/IN6-0: N6.10 (0), Q3.3 (D)
/Nixie Tube Driver/IN6-1: N6.1, Q7.3 (D)
/Nixie Tube Driver/IN6-2: N6.2, Q11.3 (D)
/Nixie Tube Driver/IN6-3: N6.3, Q15.3 (D)
/Nixie Tube Driver/IN6-4: N6.4, Q19.3 (D)
/Nixie Tube Driver/IN6-5: N6.5, Q23.3 (D)
/Nixie Tube Driver/IN6-6: N6.6, Q27.3 (D)
/Nixie Tube Driver/IN6-7: N6.7, Q31.3 (D)
/Nixie Tube Driver/IN6-8: N6.8, Q35.3 (D)
/Nixie Tube Driver/IN6-9: N6.9, Q39.3 (D)
/Nixie Tube Driver/Ser Out 1: U5.9 (QH'), U7.14 (SER)
/Nixie Tube Driver/Ser Out 2: U7.9 (QH'), U9.14 (SER)
/Nixie Tube Driver/Ser Out 3: U9.9 (QH'), U11.14 (SER)
/Nixie Tube Driver/Ser Out 4: U6.14 (SER), U11.9 (QH')
/Nixie Tube Driver/Ser Out 5: U6.9 (QH'), U8.14 (SER)
/Nixie Tube Driver/Ser Out 6: U8.9 (QH'), U10.14 (SER)
/Nixie Tube Driver/Ser Out 7: U10.9 (QH'), U12.14 (SER)
/SPI_CLK: U5.11 (SRCLK), U6.11 (SRCLK), U7.11 (SRCLK), U8.11 (SRCLK), U9.11 (SRCLK), U10.11 (SRCLK), U11.11 (SRCLK), U12.11 (SRCLK); also elsewhere on the board
/SPI_DATA: U5.14 (SER); also elsewhere on the board
GND: Q3.2 (S), Q4.2 (S), Q5.2 (S), Q6.2 (S), Q7.2 (S), Q8.2 (S), Q9.2 (S), Q10.2 (S), Q11.2 (S), Q12.2 (S), Q13.2 (S), Q14.2 (S), Q15.2 (S), Q16.2 (S), Q17.2 (S), Q18.2 (S), Q19.2 (S), Q20.2 (S), Q21.2 (S), Q22.2 (S), Q23.2 (S), Q24.2 (S), Q25.2 (S), Q26.2 (S), Q27.2 (S), Q28.2 (S), Q29.2 (S), Q30.2 (S), Q31.2 (S), Q32.2 (S), Q33.2 (S), Q34.2 (S), Q35.2 (S), Q36.2 (S), Q37.2 (S), Q38.2 (S), Q39.2 (S), Q40.2 (S), Q41.2 (S), Q42.2 (S), Q43.2 (S), Q44.2 (S), Q45.2 (S), Q46.2 (S), Q47.2 (S), Q48.2 (S), Q49.2 (S), Q50.2 (S), Q51.2 (S), Q52.2 (S), Q53.2 (S), Q54.2 (S), Q55.2 (S), Q56.2 (S), Q57.2 (S), Q58.2 (S), Q59.2 (S), Q60.2 (S), Q61.2 (S), Q62.2 (S), U5.8 (GND), U5.13 (~OE), U6.8 (GND), U6.13 (~OE), U7.8 (GND), U7.13 (~OE), U8.8 (GND), U8.13 (~OE), U9.8 (GND), U9.13 (~OE), U10.8 (GND), U10.13 (~OE), U11.8 (GND), U11.13 (~OE), U12.8 (GND), U12.13 (~OE); also elsewhere on the board
unnamed: N1.11 (A), R17.2
unnamed: N2.11 (A), R18.2
unnamed: N3.11 (A), R19.2
unnamed: N4.11 (A), R20.2
unnamed: N5.11 (A), R21.2
unnamed: N6.11 (A), R22.2

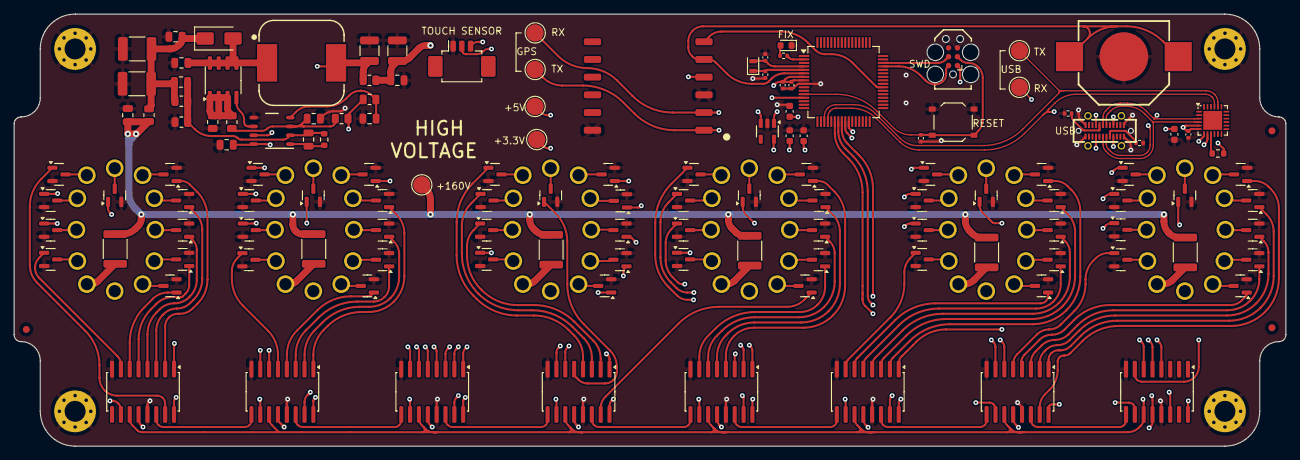
[picture p22: board gps_clock.kicad_pcb from above]

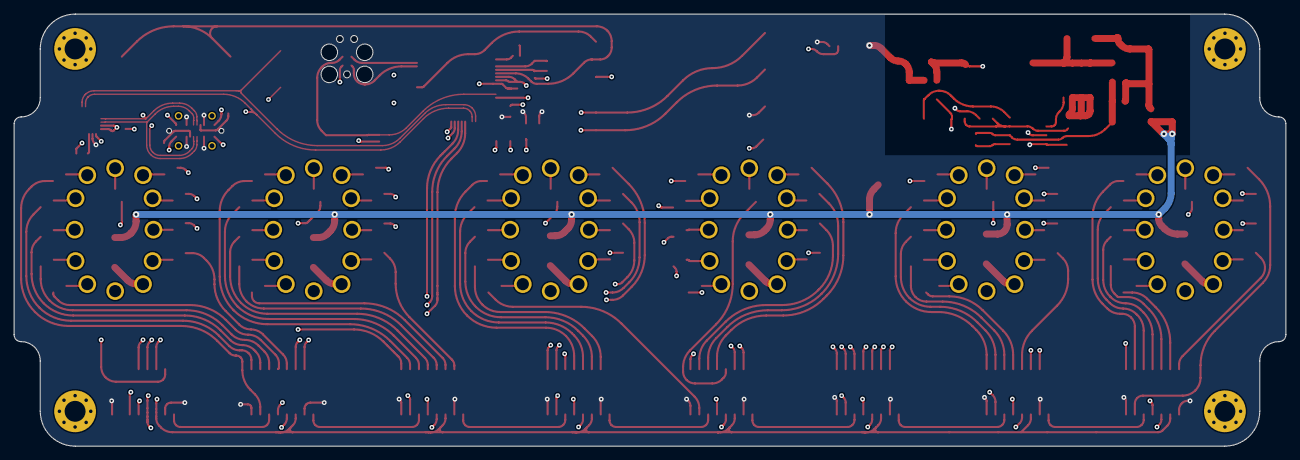
[picture p23: board gps_clock.kicad_pcb from below]

Board: 4 copper layers, 182.5 x 62.0 mm, 145 parts (6 on the bottom side), 169 nets.
