nseuf/NixieTubeClock/firmware/Core/Src/main.c

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
/* Includes ------------------------------------------------------------------*/
#include "main.h"
#include "dma.h"
#include "rtc.h"
#include "spi.h"
#include "tim.h"
#include "usart.h"
#include "gpio.h"

/* USER CODE BEGIN Includes */
#include "UTC.h"
/* USER CODE END Includes */


/* USER CODE BEGIN PV */
#define DEBUG 0
/* USER CODE END PV */

void SystemClock_Config(void);
/* USER CODE BEGIN PFP */
RTC_TimeTypeDef myTime;
RTC_DateTypeDef myDate;
bool Is12HourEnabled = false;
bool IsDST = false;

/* USER CODE END PFP */

/* USER CODE BEGIN 0 */

#define BTN_PIN			GPIO_PIN_0
#define BTN_PORT		GPIOC


uint8_t UTC_Constant = 0;

int8_t status = 0;
uint32_t ms_start;
volatile int NumPress = 0;
uint32_t button_press_time = 0;
uint32_t button_release_time = 0;
uint32_t last_press_time = 0;
uint8_t press_count = 0;
uint8_t button_state = 0;
uint8_t gpsCheck = 0;
uint8_t long_press_detected = 0;
bool inMenu = false;
int rtc_stage = -1;
static int lastCleanTime = -1;

static TimeOffset utcOffset;
int offsetMinutes;

#define BUFF_SIZE 100
char gps_buff[BUFF_SIZE];


//Takes the current status of the button, which is determined by the process_button_events() function,
//and provides functionality for the button and its different presses
void Update_Changes(int btn_status)
{
#if DEBUG==1
	if(btn_status == 1)			{	printf("Button Pressed: Once \r\n"); }
	else if(btn_status == 2)	{	printf("Button Pressed: Twice \r\n");}
	else if(btn_status == 3)	{	printf("Button Pressed: for 5 seconds\r\n");}
#endif

	//Single press changes between daylight savings time
	if(btn_status == 1){
		IsDST = !IsDST;
		BackupSettings();
	}
	//Double tap changes between 12 and 24 hour time
	else if(btn_status == 2){
		Is12HourEnabled = !Is12HourEnabled;
		BackupSettings();
	}
	//Holding the button for 5 seconds allows someone to change their UTC offsets
	else if(btn_status == 3){
		uint8_t utc_set_state = 0, button_state;
		uint32_t utc_ms_count = 0;
		uint8_t menuOpen = 0;
		inMenu = true;

		while(utc_set_state < 10){
			switch(utc_set_state){
				case 0:
					utc_ms_count = HAL_GetTick();
					utc_set_state = 1;
					Show_UTC(UTC_Constant);
					break;

				case 1:
					button_state = HAL_GPIO_ReadPin(BTN_PORT, BTN_PIN);
					if(button_state == GPIO_PIN_RESET){
						//Provides a barrier before it allows the offset to change, if this wasn't here it would
						//add one to the offset as soon as someone got into the menu
						if(menuOpen == 1) {
							if(UTC_Constant >= 38)	UTC_Constant = 1;
							else					UTC_Constant++;
						}
						HAL_Delay(100);
						#if DEBUG == 1
						//printf("new utc= %d \r\n", UTC_Constant);
						#endif
						utc_ms_count = HAL_GetTick();
						Show_UTC(UTC_Constant);
						menuOpen = 1;

						//This barrier makes sure the program doesn't loop and add to the offset while someone is
						//holding their finger on the button
						while(button_state == HAL_GPIO_ReadPin(BTN_PORT, BTN_PIN));
					}

					if(HAL_GetTick()-utc_ms_count > 5000){
						utc_set_state = 2;

						Update_Timezone();
						#if DEBUG == 1
						printf("utc success: %d \r\n",UTC_Constant);
						#endif

						//Fills the gps buffer with zeros, if the gps doesn't get a new reading it won't
						//use the previous time
						memset(gps_buff, 0, BUFF_SIZE);
					}
					break;
				case 2:
					Read_GPS(gps_buff, BUFF_SIZE);

					if(strstr(gps_buff, "$GNRMC") != NULL){
						Parse_GPGGA(gps_buff);
						utc_set_state = 20;
					}

					BackupSettings();

					inMenu = false;
					break;

				default: break;
			}

		}
	}
}

void BackupSettings(void) {
	//Adds the new offset to a backup register, this allows the offset to remain in the register even when power is lost
	uint32_t backup = 0;

	backup = UTC_Constant << 2;
    backup |= ((IsDST ? 1 : 0) << 1);
    backup |= (Is12HourEnabled ? 1 : 0);

	HAL_RTCEx_BKUPWrite(&hrtc, RTC_BKP_DR0, backup);
}


void Show_UTC(uint8_t utc_num)
{
	DisplayDigits(0, 0, 0, 0, utc_num/10, utc_num%10);

#if DEBUG == 1
	//printf("%d, %d, %d, %d, %d\r\n", test[4], test[3],test[2],test[1],test[0]);
#endif
}

Time GetLocalTime (void) {
	uint8_t newHour = -1;
	uint8_t newMin = -1;

	HAL_RTC_GetTime(&hrtc, &myTime, RTC_FORMAT_BIN);
	HAL_RTC_GetDate(&hrtc, &myDate, RTC_FORMAT_BIN);

	//myTime.Seconds = 12; myTime.Minutes = 59; myTime.Hours = 06;
	//Print_UTC_Time(myTime.Hours, myTime.Minutes, myTime.Seconds);

	int utcTotal = myTime.Hours * 60 + myTime.Minutes;

	int timeOffset = utcOffset.hours * 60 + utcOffset.minutes;

	if(IsDST) timeOffset += 60;

	int localTotal = utcTotal + timeOffset;

	if (localTotal < 0) localTotal += 1440;
	if (localTotal >= 1440) localTotal -= 1440;

	newHour = localTotal / 60;
	newMin = localTotal % 60;

	if(Is12HourEnabled){
		if(newHour > 12)
			newHour = newHour - 12;
		 if(newHour == 0)
			 newHour = 12;
	}

	Time localTime = {newHour, newMin, myTime.Seconds};

	return localTime;
}

void Show_Time(void)
{
	Time localTime = GetLocalTime();

	DisplayDigits(localTime.hours/10, localTime.hours%10,
				  localTime.minutes/10, localTime.minutes%10,
				  localTime.seconds/10, localTime.seconds%10);
}

void DisplayDigits(uint8_t hour1, uint8_t hour2, uint8_t min3, uint8_t min4, uint8_t sec5, uint8_t sec6) {
	static uint8_t shiftRegisters[8] = {0};
	uint16_t dig1, dig2, dig3, dig4, dig5, dig6;

	dig1 = 1U << sec6;
	dig2 = 1U << sec5;
	dig3 = 1U << min4;
	dig4 = 1U << min3;
	dig5 = 1U << hour2;
	dig6 = 1U << hour1;

	shiftRegisters[0] = dig1 & 0xFF;
	shiftRegisters[1] = ((dig2 & 0x3F) << 2) | ((dig1 >> 8) & 0x03);
	shiftRegisters[2] = ((dig3 & 0x0F) << 4) | ((dig2 >> 6) & 0x0F);
	shiftRegisters[3] = ((dig4 & 0x03) << 6) | ((dig3 >> 4) & 0x3F);
	shiftRegisters[4] = ((dig4 >> 2) & 0xFF);
	shiftRegisters[5] = dig5 & 0xFF;
	shiftRegisters[6] = ((dig6 & 0x3F) << 2) | ((dig5 >> 8) & 0x03);
	shiftRegisters[7] = ((dig6 >> 6) & 0x0F);

	HAL_SPI_Transmit_DMA(&hspi1, shiftRegisters, 8);
}

uint32_t f_write = 0xBABADEAD;
uint32_t f_read = 0;

/* USER CODE END 0 */

/**
  * @brief  The application entry point.
  * @retval int
  */
int main(void)
{

  /* MCU Configuration--------------------------------------------------------*/

  /* Reset of all peripherals, Initializes the Flash interface and the Systick. */
  HAL_Init();

  /* Configure the system clock */
  SystemClock_Config();

  /* Initialize all configured peripherals */
  MX_GPIO_Init();
  MX_DMA_Init();
  MX_RTC_Init();
  MX_SPI1_Init();
  MX_USART1_UART_Init();
  MX_USART2_UART_Init();
  MX_TIM7_Init();
  /* USER CODE BEGIN 2 */
#if DEBUG == 1
   printf(">> Program starts... \r\n");
#endif
   printf(">> Program starts... \r\n");

   if(HAL_RTCEx_BKUPRead(&hrtc, RTC_BKP_DR0) != 0x00) {
	   uint32_t backup = HAL_RTCEx_BKUPRead(&hrtc, RTC_BKP_DR0);

	   IsDST = backup & 10;
	   Is12HourEnabled = backup & 01;

	   UTC_Constant = backup >> 2;

	   Update_Timezone();
   }

  /* USER CODE END 2 */

  /* Infinite loop */
  /* USER CODE BEGIN WHILE */
  while (1)
  {
	  switch(rtc_stage){
		  case -1:
			 // Update_Changes(3);
			  Button_Init();
			  rtc_stage = 0;
			  break;
	  	  case 0:
	  		  Read_GPS(gps_buff, BUFF_SIZE);

			  if(strstr(gps_buff, "$GNRMC") != NULL){
				  printf(gps_buff);
				  Parse_GPGGA(gps_buff);
			  }

		  	  rtc_stage = 1;
	  		  break;

	  	  case 1:
	  		  HAL_TIM_Base_Start_IT(&htim7);

	  		  rtc_stage = 2;
	  		  break;

	  	  case 2:
#if DEBUG == 1
	  		  Read_GPS(gps_buff, BUFF_SIZE);

			  if(strstr(gps_buff, "$GNRMC") != NULL){
				  printf(gps_buff);
				  Parse_GPGGA(gps_buff);
			  }
#endif

			  int currentTime = myTime.Hours * 60 + myTime.Minutes;

			  if(currentTime != lastCleanTime && myTime.Seconds == 0) {
				  if ((myTime.Minutes % 15) == 0) {
					  //printf("%d,%d\n", myTime.Minutes, myTime.Seconds);
					  lastCleanTime = currentTime;
					  JackpotClean();
				  }
			  }

	  		  process_button_events();
	  		  Update_Changes(status);
	  		  status = -1;

	  		  break;

	  	  default: break;
	  }

    /* USER CODE END WHILE */

    /* USER CODE BEGIN 3 */
  }
  /* USER CODE END 3 */
}

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
/* USER CODE BEGIN 4 */
void JackpotClean(void) {
	inMenu = true;

	uint8_t currentDigit[6] = {0,0,0,0,0,0};  // current displayed digits
	uint8_t hour = 0;
	uint8_t minute = 0;
	uint8_t second = 0;

	const uint16_t spinDelay = 50; // ms speed of random spin
	const uint16_t cycle[10] = {0,5,2,3,9,8,7,1,4,6};
	uint8_t cycleCount = 0;
	uint32_t start = HAL_GetTick();

	// Total spin duration per tube
	uint16_t spinTimeStart[6] = {0, 1000, 2000, 3000, 4000, 5000};
	uint16_t spinTimeEnd[6] = {1000, 2000, 3000, 4000, 5000, 6000};

	while (1) {
		uint32_t current = HAL_GetTick();
		int complete = 1;

		Time localTime = GetLocalTime();

		hour = localTime.hours;
		minute = localTime.minutes;
		second = localTime.seconds;

		// Target digits
		uint8_t target[6] = {hour / 10, hour % 10, minute / 10, minute % 10, second / 10, second % 10};

		for (int i = 0; i < 6; i++) {
			if (current - start >= spinTimeStart[i] && current - start < spinTimeEnd[i]) {
				complete = 0;

				currentDigit[i] = cycle[cycleCount % 10];
			} else if (current - start >= spinTimeEnd[i]) {
				complete = 1;

				currentDigit[i] = target[i]; // land on correct digit
			} else {
				currentDigit[i] = target[i]; // land on correct digit
			}
		}

		// Display the 6 digits
		DisplayDigits(currentDigit[0], currentDigit[1], currentDigit[2],
				currentDigit[3], currentDigit[4], currentDigit[5]);

		HAL_Delay(spinDelay);

		cycleCount++;

		if (complete) break;
	}

	inMenu = false;
	Show_Time();
}


void Read_GPS(char *buff, uint8_t size)
{
	uint8_t idx = 0;

	MX_USART1_UART_Init();
	USART1->CR1 |= USART_CR1_RE;
	while(idx < size)
	{
		if(USART1->ISR & USART_ISR_RXNE_RXFNE){
			buff[idx] = USART1->RDR;
			if(buff[idx] == '\n'){
				buff[++idx] = '\0';
				return;
			}
			idx++;
		}
	}

	USART1->CR1 &= ~USART_CR1_RE;

}

void Parse_GPGGA(char *sentence)
{
	uint8_t sec = 0, min = 0, hour = 0;
	char utc_time[10] = "";
	char gpsParsed[15][10] = { NULL };
	uint8_t i = 0;

	char* token = strtok(sentence, ",");

	do {
		strcpy(gpsParsed[i], token);
		token = strtok(NULL, ",");
		i++;
	} while(token != NULL);

	//token = strtok(NULL, ",");

	snprintf(utc_time, sizeof(utc_time), "%s", gpsParsed[1]);  // Copy the time string

	// Extract hours, minutes, and seconds
	hour = (utc_time[0] - '0') * 10 + (utc_time[1] - '0');
	min = (utc_time[2] - '0') * 10 + (utc_time[3] - '0');
	sec = (utc_time[4] - '0') * 10 + (utc_time[5] - '0');

#if DEBUG == 1
	//Print_UTC_Time(hour, min, sec);
#endif
	//RTC_SetTime(hour, min, sec);

	if(gpsParsed[6][0] == '1' || gpsParsed[6][0] == '2' || gpsParsed[2][0] == 'A' || gpsParsed[1][6] == '.'){
		RTC_SetTime(hour, min, sec);
		RTC_SetDate(24, RTC_MONTH_DECEMBER, 20, RTC_WEEKDAY_SUNDAY);

		HAL_GPIO_WritePin(GPIOC, GPIO_PIN_12, 1);
	} else {
		//Turn off led when no gps signal
		HAL_GPIO_WritePin(GPIOC, GPIO_PIN_12, 0);
	}
	//Update_Changes(0);*/
}

void Print_UTC_Time(uint8_t hour, uint8_t minute, uint8_t second) {
	char time_str[25];
    snprintf(time_str, sizeof(time_str), "UTC Time: %02d:%02d:%02d \r\n", hour, minute, second);
    HAL_UART_Transmit(&huart2, (uint8_t*)time_str, strlen(time_str), 100);
}

void Update_Timezone() {
	utcOffset = calculate_utc_offset(UTC_Constant);
	offsetMinutes = utcOffset.hours * 60 + utcOffset.minutes;
}

//Takes UTC time from the GPS to set the RTC
void RTC_SetTime(uint8_t hour, uint8_t min, uint8_t sec)
{
	RTC_TimeTypeDef sTime;

	sTime.Hours = hour;
	sTime.Minutes = min;
	sTime.Seconds = sec;
	sTime.SubSeconds = 0;
	sTime.TimeFormat = RTC_HOURFORMAT12_AM;
	sTime.DayLightSaving = RTC_DAYLIGHTSAVING_NONE;
	sTime.StoreOperation = RTC_STOREOPERATION_RESET;
	if (HAL_RTC_SetTime(&hrtc, &sTime, RTC_FORMAT_BIN) != HAL_OK)
	{
		Error_Handler();
	}

	//Print_UTC_Time(new_hour, new_min, sec);
}

void RTC_SetDate(uint8_t year, uint8_t month, uint8_t date, uint8_t day)
{
	RTC_DateTypeDef sDate = {0};

	sDate.WeekDay = day;
	sDate.Month = month;
	sDate.Date = date;
	sDate.Year = year;

	if (HAL_RTC_SetDate(&hrtc, &sDate, RTC_FORMAT_BIN) != HAL_OK)
	{
		Error_Handler();
	}
}

void Button_Init(void)
{
	GPIO_InitTypeDef GPIO_InitStruct = {0};
	/* GPIO Ports Clock Enable */
	__HAL_RCC_GPIOC_CLK_ENABLE();
	__HAL_RCC_GPIOA_CLK_ENABLE();
	__HAL_RCC_GPIOB_CLK_ENABLE();

	/*Configure GPIO pin Output Level */
	HAL_GPIO_WritePin(BTN_PORT, BTN_PIN, GPIO_PIN_RESET);


	GPIO_InitStruct.Pin = BTN_PIN;
	GPIO_InitStruct.Mode = GPIO_MODE_INPUT;
	GPIO_InitStruct.Pull = GPIO_PULLUP;
	HAL_GPIO_Init(BTN_PORT, &GPIO_InitStruct);
}

void HAL_TIM_PeriodElapsedCallback(TIM_HandleTypeDef *htim){
	static int8_t timeElapsed = 5;

	if(htim->Instance == TIM7) {
		if(gpsCheck == timeElapsed) {
			Read_GPS(gps_buff, BUFF_SIZE);

			if(strstr(gps_buff, "$GNRMC") != NULL){
			  printf(gps_buff);
			  Parse_GPGGA(gps_buff);
			}

			gpsCheck = 0;
		} else {
			gpsCheck++;
		}
	}
}

//In rtc.c by setting the alarm such that the alarm mask has RTC_ALARMMASK_ALL set the alarm will trigger every second
//This allows for a good display driver that is bound to the rtc, rather than using a timer
void HAL_RTC_AlarmAEventCallback(RTC_HandleTypeDef *hrtc) {
	if(!inMenu) {
		Show_Time();
	}
}

void HAL_SPI_TxCpltCallback(SPI_HandleTypeDef *hspi){
	HAL_GPIO_WritePin(GPIOA, GPIO_PIN_6, 1);
	HAL_GPIO_WritePin(GPIOA, GPIO_PIN_6, 0);
}

void process_button_events(void)
{
    //static uint32_t debounce_time = 0;
    static uint8_t pending_single_press = 0;

    // Read the button state
    uint8_t current_state = HAL_GPIO_ReadPin(BTN_PORT, BTN_PIN);

    if (current_state == GPIO_PIN_RESET && button_state == 0) {
        // Button Press Detected
        button_press_time = HAL_GetTick();
        button_state = 1;
        if ((button_press_time - last_press_time) < 1000) {
            press_count++;
        } else {
            press_count = 1;
        }
        last_press_time = button_press_time;
    }

    if (current_state == GPIO_PIN_SET && button_state == 1) {
        // Button Released
        button_release_time = HAL_GetTick();
        button_state = 0;

        if (!long_press_detected) {
            if (press_count == 1) {
                // Mark a pending single press
                pending_single_press = 1;
            } else if (press_count == 2) {
                // Handle double press immediately
                //double_press_event();
            	status = 2;
                press_count = 0;
                pending_single_press = 0; // Clear pending single press
            }
        }
        long_press_detected = 0;
    }

    // Check for long press
    if (button_state == 1 && (HAL_GetTick() - button_press_time) > 3000 && !long_press_detected) {
        long_press_detected = 1;
        //long_press_event();
        status = 3;
        pending_single_press = 0; // Cancel pending single press
    }

    // Handle single press after a delay to confirm no double press
    if (pending_single_press && (HAL_GetTick() - last_press_time) > 300) {
        //single_press_event();
    	status = 1;
        pending_single_press = 0; // Clear pending single press
    }
}


void _putchar(char character)
{
	while(!(USART2->ISR & UART_FLAG_TXE));
	USART2->TDR = character & 0xFF;
}

/* USER CODE END 4 */
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
