nseuf/NixieTubeClock/firmware/RTCClock.ioc

Mcu.UserName=STM32G070RBTx
PA13.Signal=SYS_SWDIO
PA14-BOOT0.Signal=SYS_SWCLK
PA2.Signal=USART2_TX
PA3.Signal=USART2_RX
PA5.Signal=SPI1_SCK
PA6.Signal=GPIO_Output
PA7.Signal=SPI1_MOSI
PC12.Signal=GPIO_Output
PC4.Signal=USART1_TX
PC5.Signal=USART1_RX
