nseuf/NixieTubeClock/(commit log)

2025-08-10 prototype firmware
    [RTCClock Debug.cfg]
2025-08-10 pcb firmware
2025-08-10 created pcbs
    [TouchSensor-B_Cu.dxf, TouchSensor-B_Mask.dxf, TouchSensor-Edge_Cuts.dxf, TouchSensor-F_Cu.dxf, TouchSensor-F_Mask.dxf, TouchSensor-User_Eco1.dxf, TouchSensor.kicad_pcb, TouchSensor.kicad_sch]
2025-08-10 updated pcb
    [TouchSensor.kicad_pcb, TouchSensor.kicad_sch, TouchSensor.step, bom.csv, designators.csv, gps_clock.kicad_pcb, gps_clock.kicad_sch, panel.kicad_pcb]
2025-08-10 removed panels
    [panel.kicad_pcb]
2025-08-10 created housings
    [BackFace.x_t, Clock.Housing.x_t, FrontFace.x_t, PCB Holder.step]
2025-09-24 added clock assembly drawings
2025-11-16 Redesigned the touch pcb holder
    [2025.06.16.Clock.PCB Holder Part1.STL]
2025-11-16 Added second part of the pcb holder
    [2025.06.11.Cock.PCB Holder Part2.STL]
2025-11-16 fixed passthrough circuit
    [USBCPassthrough.kicad_pcb, USBCPassthrough.kicad_sch]
2025-11-16 Rename 2025.06.11.Cock.PCB Holder Part2.STL to 2025.06.11.Clock.PCB Holder Part2.STL
    [2025.06.11.Clock.PCB Holder Part2.STL, 2025.06.11.Cock.PCB Holder Part2.STL]
2025-11-20 Added production files
    [bom.csv, designators.csv, positions.csv]
2026-01-13 Update part
    [2025.06.11.Clock.PCB Holder Part2.STL]
